PedroMO11/iot-proyecto/docs/resultados/2026-10-21_emg_antebrazo.png

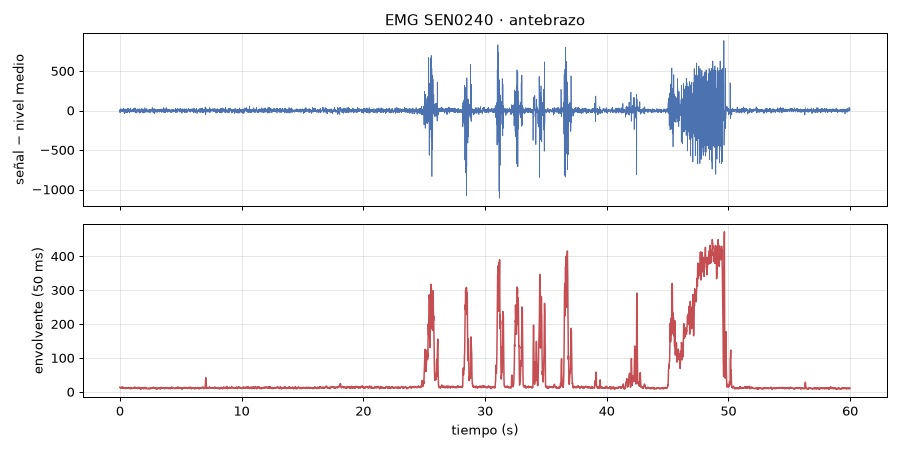
docs/resultados/2026-10-21_emg_antebrazo.png
