PedroMO11/iot-proyecto/docs/resultados/2026-10-28_emg_antebrazo_notch.png

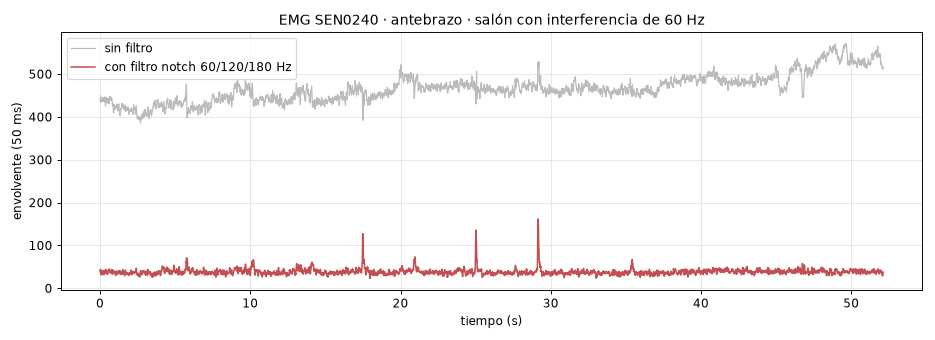
docs/resultados/2026-10-28_emg_antebrazo_notch.png
