PedroMO11/iot-proyecto/docs/resultados/2026-10-28_emg_masetero_ruido.png

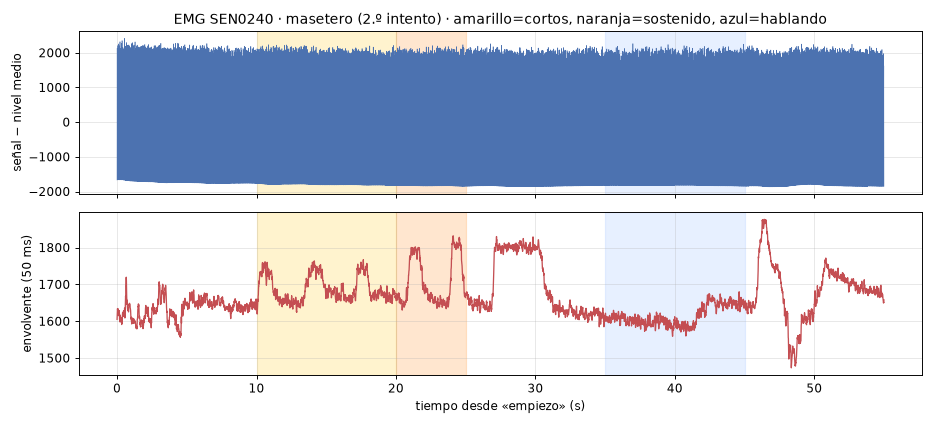
docs/resultados/2026-10-28_emg_masetero_ruido.png
