PedroMO11/iot-proyecto/docs/resultados/2026-10-28_max30102_pulso.png

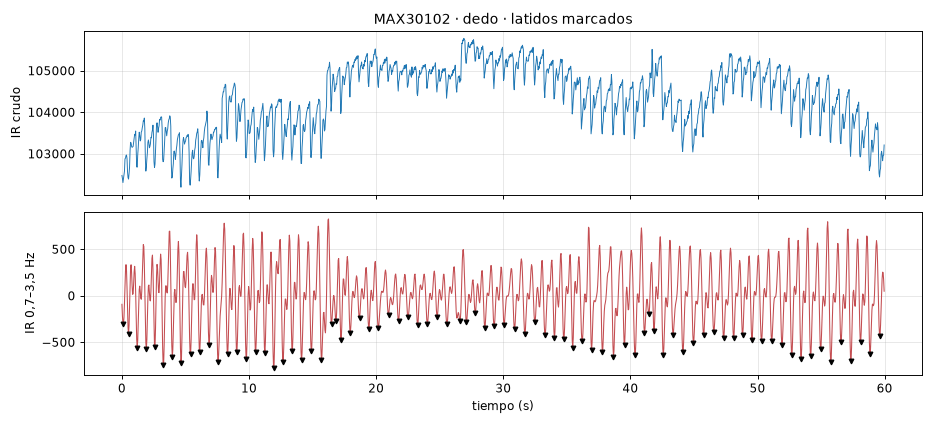
docs/resultados/2026-10-28_max30102_pulso.png
