PedroMO11/iot-proyecto/docs/resultados/2026-10-28_mpu6050_prueba.png

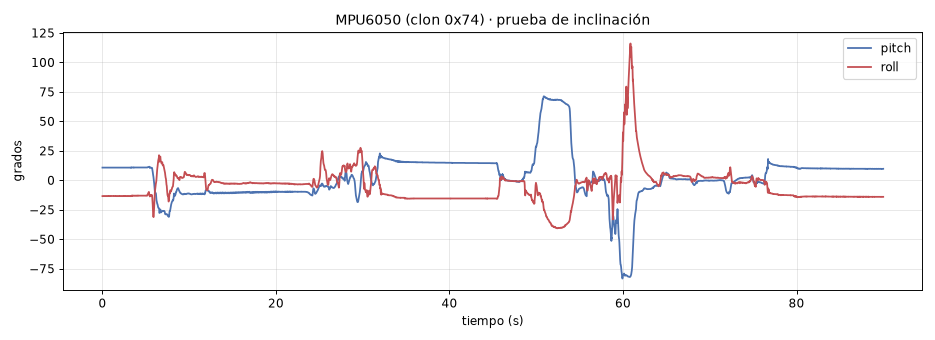
docs/resultados/2026-10-28_mpu6050_prueba.png
