PedroMO11/iot-proyecto/docs/resultados/2026-10-29_emg_masetero_casa.png

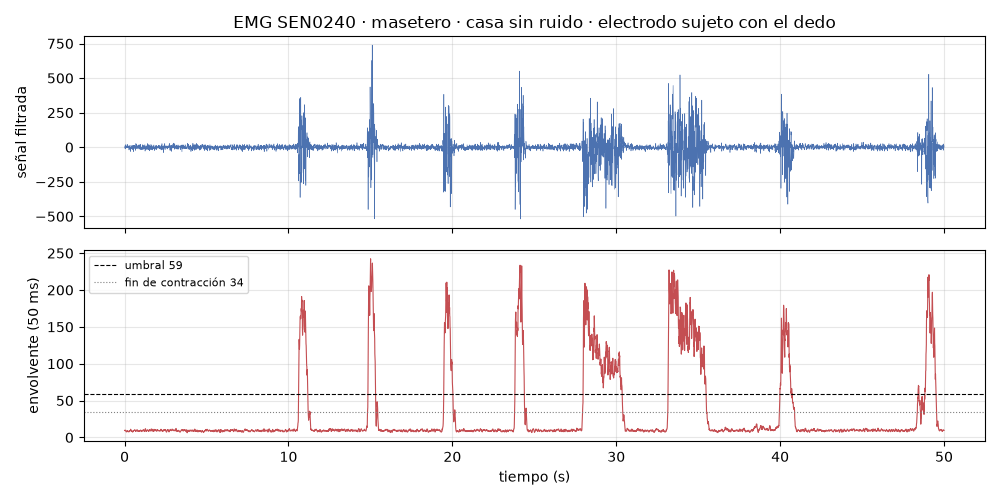
docs/resultados/2026-10-29_emg_masetero_casa.png
