PedroMO11/iot-proyecto/firmware/pruebas/02b_coexistencia/02b_coexistencia.ino

// 02b_coexistencia.ino : WiFi + MQTT + Bluetooth A2DP al mismo tiempo, con relé y buzzer por MQTT
#include <WiFi.h>
#include <PubSubClient.h>
#include <ArduinoJson.h>
#include "BluetoothA2DPSource.h"
#include "frases.h"

// ---- Configuración: WiFi, IP del broker y parlante ----
// Copiar firmware/nodo_asistivo/config.example.h como config.h en esta carpeta y completarlo.
// config.h está en .gitignore: NUNCA subirlo (tiene la contraseña del WiFi).
#if __has_include("config.h")
#include "config.h"
#else
#error "Falta config.h: copiar firmware/nodo_asistivo/config.example.h como config.h en esta carpeta"
#endif

const char* T_CMD    = "asistivo/nodo1/cmd";
const char* T_PING   = "asistivo/nodo1/ping";
const char* T_PONG   = "asistivo/nodo1/pong";
const char* T_ESTADO = "asistivo/nodo1/estado";

const int PIN_RELE   = 26;
const int PIN_BUZZER = 27;              // buzzer activo directo al GPIO (suena bien a 3,3 V)
const uint32_t ALERTA_MS = 2000;

WiFiClient wifiClient;
PubSubClient mqtt(wifiClient);
BluetoothA2DPSource a2dp;

// ---- Audio (igual que en la prueba A) ----
volatile int fraseActual = -1;
volatile float posicion = 0;
const float PASO = 16000.0f / 44100.0f;
const float GANANCIA = 2.5f;            // los WAV llegan con pico ~12000/32767; x2,5 no satura

// ESP32-A2DP 1.8.11 no reintenta sola tras una desconexión: se queda quieta.
// Cada RECONEXION_MS sin parlante se vuelve a llamar a la última dirección conocida.
const uint32_t RECONEXION_MS = 10000;

// La librería solo acepta nombres que empiecen exactamente igual. Con el Xiaomi
// funcionó mejor buscar PARLANTE dentro del nombre, sin distinguir mayúsculas.
bool esParlante(const char* nombre, esp_bd_addr_t direccion, int rssi) {
  String visto = nombre, buscado = PARLANTE;
  visto.toLowerCase();
  buscado.toLowerCase();
  bool coincide = visto.indexOf(buscado) >= 0;
  Serial.printf("Visto: \"%s\" (RSSI %d)%s\n", nombre, rssi, coincide ? " <- parlante" : "");
  return coincide;
}

int32_t get_data_frames(Frame* frame, int32_t frame_count) {
  for (int i = 0; i < frame_count; i++) {
    int16_t muestra = 0;
    int f = fraseActual;
    if (f >= 0) {
      uint32_t idx = (uint32_t)posicion;
      if (idx < FRASES_LEN[f]) {
        muestra = constrain(FRASES[f][idx] * GANANCIA, -32768.0f, 32767.0f);
        posicion += PASO;
      }
      else fraseActual = -1;
    }
    frame[i].channel1 = muestra;
    frame[i].channel2 = muestra;
  }
  delay(1);
  return frame_count;
}

void reproducir(int id) {
  if (id < 1 || id > NUM_FRASES) return;
  posicion = 0;
  fraseActual = id - 1;
  Serial.printf("Frase %d\n", id);
}

// ---- Actuadores ----
bool luz = false;
bool alertaActiva = false;
uint32_t inicioAlerta = 0;

void conmutarLuz() {
  luz = !luz;
  digitalWrite(PIN_RELE, luz ? RELE_ENCENDIDO : !RELE_ENCENDIDO);
  Serial.printf("Luz %s\n", luz ? "ENCENDIDA" : "APAGADA");
}

void alerta() {                         // el loop apaga el buzzer tras ALERTA_MS, sin bloquear
  digitalWrite(PIN_BUZZER, HIGH);
  alertaActiva = true;
  inicioAlerta = millis();
  Serial.println("Alerta: buzzer ON");
}

// ---- MQTT ----
void alRecibir(char* topic, byte* payload, unsigned int len) {
  char msg[128];                                       // copiar: el buffer de PubSubClient se reutiliza
  len = min(len, (unsigned int)sizeof(msg) - 1);
  memcpy(msg, payload, len);
  msg[len] = '\0';

  if (strcmp(topic, T_PING) == 0) {                    // eco para medir latencia
    mqtt.publish(T_PONG, msg);
    return;
  }
  JsonDocument doc;
  if (deserializeJson(doc, msg)) { Serial.println("JSON inválido"); return; }
  if (doc["accion"] == "frase") {
    int id = doc["id"] | 0;
    reproducir(id);
    if (id == 4) conmutarLuz();         // "Enciende la luz"
    if (id == 5) alerta();              // "Llamar al cuidador"
  }
  else if (doc["accion"] == "luz") conmutarLuz();     // por ahora solo "estado":"toggle"
  else if (doc["accion"] == "alerta") alerta();
}

void conectarMqtt() {
  static uint32_t ultimoIntento = 0;
  if (mqtt.connected() || millis() - ultimoIntento < 2000) return;
  ultimoIntento = millis();
  Serial.print("Conectando a MQTT... ");
  // LWT: si el ESP32 se cae, el broker publica "offline"
  if (mqtt.connect("esp32-nodo1", T_ESTADO, 1, true, "offline")) {
    Serial.println("OK");
    mqtt.publish(T_ESTADO, "online", true);
    mqtt.subscribe(T_CMD, 1);
    mqtt.subscribe(T_PING, 1);
  } else {
    Serial.printf("falló (rc=%d)\n", mqtt.state());
  }
}

void setup() {
  Serial.begin(115200);
  pinMode(PIN_RELE, OUTPUT);
  digitalWrite(PIN_RELE, !RELE_ENCENDIDO);
  pinMode(PIN_BUZZER, OUTPUT);
  digitalWrite(PIN_BUZZER, LOW);

  WiFi.mode(WIFI_STA);
  WiFi.begin(WIFI_SSID, WIFI_PASS);
  Serial.print("Conectando WiFi");
  while (WiFi.status() != WL_CONNECTED) { delay(500); Serial.print("."); }
  Serial.printf("\nWiFi OK, IP: %s\n", WiFi.localIP().toString().c_str());
  // IMPORTANTE: no usar WiFi.setSleep(false). Con Bluetooth activo, el WiFi
  // necesita su modo de ahorro para compartir la radio.

  mqtt.setServer(MQTT_HOST, 1883);
  mqtt.setCallback(alRecibir);
  mqtt.setKeepAlive(5);                 // el broker publica el LWT tras ~7,5 s sin noticias (por defecto, ~22 s)

  a2dp.set_data_callback_in_frames(get_data_frames);
  a2dp.set_ssid_callback(esParlante);
  a2dp.set_volume(127);                 // 0 a 127 (máximo)
  a2dp.set_auto_reconnect(true);        // guarda la dirección en la NVS y la usa al arrancar
  a2dp.start();                         // sin nombre: decide esParlante
}

void loop() {
  conectarMqtt();
  mqtt.loop();

  static bool btAntes = false, huboConexion = false;
  static uint32_t ultimoIntento = 0;
  bool bt = a2dp.is_connected();
  if (bt != btAntes) {
    btAntes = bt;
    if (bt) huboConexion = true;
    ultimoIntento = millis();
    Serial.println(bt ? "Parlante CONECTADO" : "Parlante desconectado");
  }
  if (!bt && huboConexion && millis() - ultimoIntento >= RECONEXION_MS) {
    ultimoIntento = millis();
    Serial.println("Reintentando conexión con el parlante...");
    a2dp.reconnect();
  }
  if (alertaActiva && millis() - inicioAlerta >= ALERTA_MS) {
    digitalWrite(PIN_BUZZER, LOW);
    alertaActiva = false;
    Serial.println("Alerta: buzzer OFF");
  }
  if (Serial.available()) {
    char c = Serial.read();
    if (c >= '1' && c <= '9') reproducir(c - '0');
    if (c == 'a') alerta();
    if (c == 'l') conmutarLuz();
  }
  delay(5);
}
