PedroMO11/iot-proyecto/(commit log)

2026-10-21 @ Agregar frases TTS y configurar audífonos ULT WEAR
    - audios/: 6 frases generadas en ttsmaker.com (.mp3), convertidas a
    WAV mono 16 bits 16 kHz con silencios recortados y volumen
    normalizado, y frases.h generado (169 KB de flash).
    - 02a_a2dp_solo y 02b_coexistencia: frases.h real en lugar del
    marcador en silencio, y PARLANTE = "ULT WEAR" (audífonos Sony).
    - audios/README.md: documentar el origen TTS y el comando de
    conversión con ffmpeg.
    @
2026-10-21 firmware: A2DP y coexistencia WiFi + MQTT + Bluetooth funcionando
    - 02a y 02b: volumen 127 y ganancia digital x2,5 (los WAV TTS llegan con
    pico ~12000 de 32767; con x2,5 no satura). Probado con los Sony ULT WEAR.
    - 02a y 02b: reconexión del parlante. ESP32-A2DP 1.8.11 trae la
    reconexión desactivada y tras una desconexión se queda quieta; ahora se
    activa set_auto_reconnect(true) (guarda la dirección en la NVS) y se
    llama a reconnect() cada 10 s. Probado apagando y prendiendo los
    audífonos.
    - 02b: keepalive MQTT de 5 s para que el LWT "offline" llegue en ~7,5 s.
    - docs/resultados: latencia MQTT con y sin audio (30/30 pings en ambos;
    ida promedio 108 y 113 ms, máximo 497 y 440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
2026-10-21 Mover WiFi, broker y parlante de 01 y 02b a config.h (ignorado por git)
    [01_mqtt_basico.ino, 02b_coexistencia.ino]
2026-10-21 docs: LWT, estabilidad parcial y primera señal del EMG en el antebrazo
    - CHECKLIST_ARMADO: LWT probado (offline en 3,6 s y 6 s con keepalive de
    5 s; al reconectar, online en ~2 s y audífonos en ~20 s). Estabilidad
    parcial: 3,6 min sin reinicios ni caídas (214/214 pings).
    - EMG SEN0240 en el antebrazo: reposo ~11 cuentas, puños 300-420 (~30x).
    Simulando 03c_emg_eventos sobre la grabación, el umbral μ+20 (~31) da
    falsos positivos en reposo; ~60 no. Falta probarlo en el masetero.
    - Nota de diagnóstico: señal plana en 0 = GPIO34 saturado a 4095.
    - docs/resultados: gráfica y datos crudos (100 Hz) del EMG.
2026-10-28 firmware: MPU6050 (clon) y MAX30102 funcionando en el ESP32
    - 03a_mpu6050: lee los registros directamente. El GY-521 del grupo trae un
    chip compatible con WHO_AM_I = 0x74 y la librería de Adafruit lo
    rechazaba. Probado: ruido ±0,05°, sin deriva; adelante = pitch +,
    izquierda = roll −.
    - 03b_max30102 (nuevo): Example8_SPO2 adaptado al ESP32. El ejemplo colgaba
    el chip (GPIO11 es de la flash); la librería perdía muestras (~10 de 25/s)
    y ahora la FIFO se lee directo; brillo 30 (con 60 se saturaba al 96 %);
    si el sensor deja de responder, lo reinicia. Probado: 25 muestras/s,
    pulso ~79 BPM con análisis propio, SpO2 99 %. El pulso del algoritmo de
    Maxim no sirve (125 BPM).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
2026-10-28 laptop: interfaz del paciente, dashboard del cuidador y simulador del nodo
    - laptop/interfaz: menú 2×3 a pantalla completa (página web). Cursor por
    imu/evento, vision/mirada o teclado; EMG confirma o cancela; publica en
    cmd e interfaz/seleccion. Modos uso, prueba (objetivo, acierto, tiempo)
    y reposo (activaciones accidentales).
    - dashboard: suscrito a asistivo/#; calcula las métricas con meta: pulso
    y SpO2 con alerta, aciertos, tiempo de selección, accidentales por
    5 min, latencia por ping/pong (mediana y p90) y disponibilidad del
    nodo. Gráficos de 5 min, registro de eventos y exportar CSV.
    - laptop/web: cliente MQTT 3.1.1 por WebSocket y configuración, sin
    librerías ex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
2026-10-28 firmware: filtro de 60 Hz para el EMG y pruebas en el masetero
    - 03c_emg_senal: filtro notch en 60/120/180 Hz (biquad a 1 kHz; conserva
    el 87 % de la banda de 20–450 Hz). En el salón, con la laptop a batería,
    el 94 % de la señal en reposo era la red eléctrica; con el filtro el
    reposo bajó de 424 a 37. Imprime la envolvente con y sin filtro.
    - 03c_emg_eventos: margen mínimo del umbral de +20 a +50 (con +20 había
    falsos en reposo en la grabación del antebrazo).
    - CHECKLIST: ese día el sensor no mostró contracciones ni en el masetero
    (saturaba el ADC) ni en el antebrazo; pendiente repetir donde funcionó y
    revisar el cable de 3,5 mm. Cambio de parlante (Xiaomi Sound Pock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
2026-10-28 firmware: buzzer directo a D27 y alerta por MQTT
    - 02b_coexistencia: acciones "alerta" (buzzer 2 s, sin bloquear) y
    "luz" (conmuta el relé); la frase 4 conmuta la luz y la frase 5 activa
    el buzzer. Teclas a / l por el Monitor Serie para probar sin MQTT.
    - Buzzer activo de 2 patas conectado directo al GPIO27, sin transistor:
    suena bien a 3,3 V. Probado con 04b_buzzer y con
    mosquitto_pub {"accion":"alerta"} y {"accion":"frase","id":5}.
    - CHECKLIST, README y COMPRAS actualizados (el transistor queda solo
    para el relé). Nota sobre rc=-2 cuando la laptop sale del hotspot.
    [02b_coexistencia.ino]
2026-10-29 firmware: EMG de eventos con filtro de 60 Hz e histéresis, probado en el masetero
    - 03c_emg_eventos: filtro notch en 60/120/180 Hz (igual que 03c_emg_senal),
    histéresis (la contracción termina a la mitad entre μ y el umbral) y aviso
    si la señal toca los extremos del ADC. Con GRAFICAR = true muestra la
    envolvente y los umbrales en el Serial Plotter. Sobre la grabación del
    salón del 2026-10-28, sin histéresis los apretones largos daban CONFIRMAR
    en vez de CANCELAR.
    - Masetero en casa sin ruido (2026-10-29, electrodo sujeto con el dedo):
    reposo ~9, apretones de 180-240, sin saturar. 15 CONFIRMAR en 65 s,
    2 de 2 CANCELAR y 0 falsos en 5 min hablando y tragando.
    - Dos tragad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
2026-10-31 laptop: módulo de visión con MediaPipe FaceLandmarker
    vision.py lee la webcam, estima la región de la mirada (1..6) y la
    publica en asistivo/vision/mirada solo cuando cambia. Incluye
    calibración de 6 casillas a pantalla completa, suavizado con histéresis
    y descarte de parpadeos. El modelo se descarga solo y, junto con la
    calibración, queda fuera de git.
2026-10-31 repo: dashboard dentro de laptop/ y README al día
    - dashboard/ pasa a laptop/dashboard/, junto a la interfaz con la que
    comparte laptop/web/.
    - Se quitan los .gitkeep de carpetas que ya tienen archivos.
    - simulador_nodo.py y latencia_mqtt.py aceptan --broker y --puerto.
    - simulador_nodo.py ya no se cae en Windows con la salida redirigida
    (UnicodeEncodeError al imprimir ♪ mataba el hilo de MQTT).
    - README: estructura, rutas del dashboard, visión en el paso 6 y aviso
    del servicio de Mosquitto en Windows sin el puerto 9001.
2026-10-31 repo: entorno de Python con uv
    - pyproject.toml + uv.lock reemplazan a laptop/requirements.txt.
    Python 3.12 fijado en .python-version.
    - Solo opencv-contrib-python (la que exige mediapipe): con opencv-python
    además quedaban instalados dos cv2 que se pisan. numpy se declara
    porque vision.py lo importa directo.
    - README, CHECKLIST, audios/README y los encabezados de los scripts usan
    uv sync / uv run.
2026-10-31 laptop: mirada con MediaPipe, cursor de mirada y dashboard rediseñado
    - laptop/vision/mirada.py: webcam + MediaPipe Face Landmarker. Rasgos de
    los ojos (iris y blendshapes) → regresión ridge → punto (x, y) donde
    mira el usuario, suavizado; la casilla es la que queda bajo el punto
    (voto por mayoría y 0,3 s). Calibración de 6 casillas guiada desde la
    interfaz (tecla C), guardada con sus muestras; recentrado de 1 punto
    (tecla O). Usa solo los ojos: con la cabeza, un giro mínimo movía el
    cursor un 11 % de la pantalla, y en muestras no vistas acertaba 129/144
    casillas frente a 143/144 solo con los ojos. El modelo se descarga solo.
    - Interfaz: cursor de mirada (círculo que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
2026-10-31 visión: seguimiento de la mirada rehecho (pose 3D, 10 puntos, modelo elegido por validación cruzada)
    - modelo.py (nuevo): 20 rasgos por cuadro (iris de cada ojo en píxeles
    reales y corregido por el alabeo, apertura de párpados, 8 blendshapes de
    mirada y pose 3D de la cabeza de la matriz de MediaPipe). Prueba 48
    variantes de modelo y elige la de menor error con validación cruzada
    dejando fuera un punto entero. Filtro One Euro e histéresis de casillas.
    - mirada.py: cámara a 1280x720 y 30 fps (MJPG), antiparpadeo en 60 Hz y
    sin bajar los fps con poca luz; calibración de 10 puntos (rejilla de
    3x3 con centro y bordes), comprobación en los 6 centros de casilla con %
    de acier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
2026-11-04 firmware: nodo integrado (audio, EMG, cabeza, pulso, relé, buzzer) y prueba de conjunto
    - nodo_asistivo: une lo aprobado en firmware/pruebas. Tareas en el núcleo 1:
    EMG a 1 kHz con filtro de 60 Hz y calibración en reposo (emg.h), y bus I2C
    a 100 Hz con MPU6050 (gestos: neutro de 2 s, 15° con histéresis a 7°, eje
    dominante; imu.h) y MAX30102 (FIFO directa, pulso con algoritmo propio
    —79 BPM sobre la grabación real— y SpO2 de Maxim; pulso.h). loop(): WiFi,
    MQTT con LWT, ping/pong, actuadores (relé con transistor, buzzer sin
    bloquear), comandos y diagnóstico cada 5 s. Parlante por parte del nombre,
    olvida el anterior si cambia (audio.h). Módulos activables en config.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
    [audio.h, config.example.h, emg.h, frases.h, imu.h, nodo_asistivo.ino, pulso.h]
2026-11-05 firmware: buscar el parlante por parte del nombre y probar el buzzer en 02a
    [02a_a2dp_solo.ino, 02b_coexistencia.ino]
2026-11-05 firmware: histéresis y aviso de saturación del EMG en el nodo integrado
    Lleva al emg.h del nodo lo probado en 03c_emg_eventos: la contracción termina al bajar de μ + 0,5·(umbral − μ), para que un apretón largo dé CANCELAR y no se parta en dos CONFIRMAR, y la calibración avisa si más del 1 % de las muestras toca los extremos del ADC. Corrige el comentario del buzzer: va directo a D27, sin transistor.
    [config.example.h, emg.h]
2026-11-12 firmware: relé de 2 canales directo a D26, IMU en la frente y prueba del foco por MQTT
    - Relé: el módulo de 2 canales va con VCC a 5 V e IN directo a D26, se enciende con LOW; ya no hace falta el 2N2222.
    - IMU_FRENTE: gira los ejes del MPU6050 cuando va vertical en la frente.
    - 04c_rele_mqtt y laptop/pruebas/foco.py para probar solo el foco (on, off, toggle).
    - El simulador acepta estado on/off además de toggle.
2026-11-12 docs: foco de 220 V en el relé, checklist completo y contexto para el informe P2
    - El relé enciende un foco de 220 V: README, COMPRAS y CHECKLIST al día, con la conexión y los cuidados.
    - Checklist marcado como probado, incluida la prueba de conjunto (faltan los valores de la etapa 6).
    - docs/CONTEXTO_INFORME_P2.md: lo necesario para redactar el informe P2.
